brokebit/PA-Sequencer-Hardware/Sequencer-3d.png

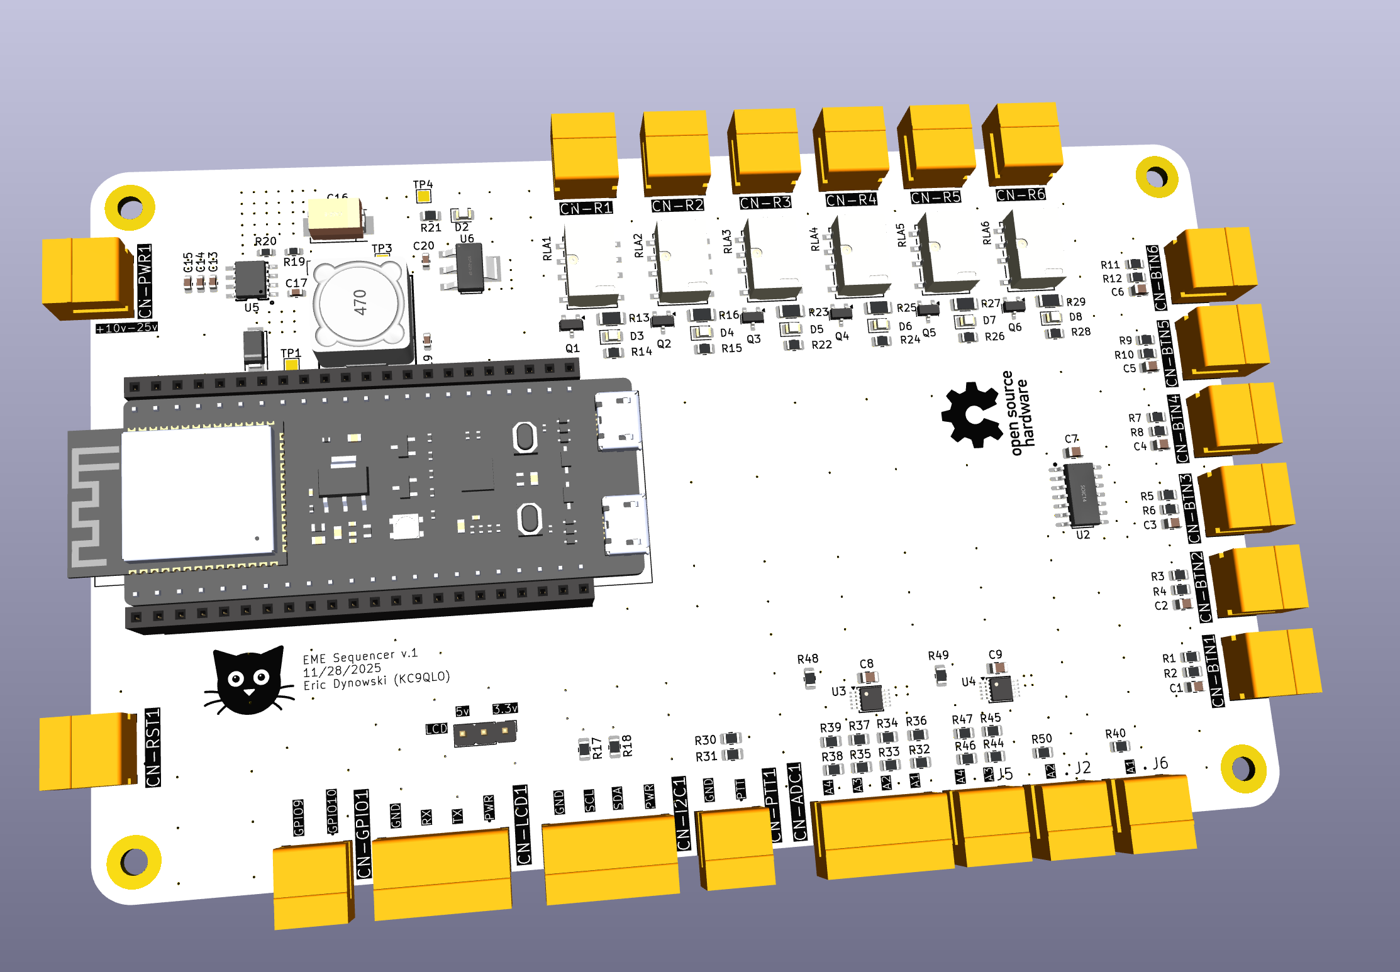
Sequencer-3d.png
