brokebit/PA-Sequencer-Hardware/parts/C2982926_Relay-G6K_2F_Y/G6K_2F_Y.igs

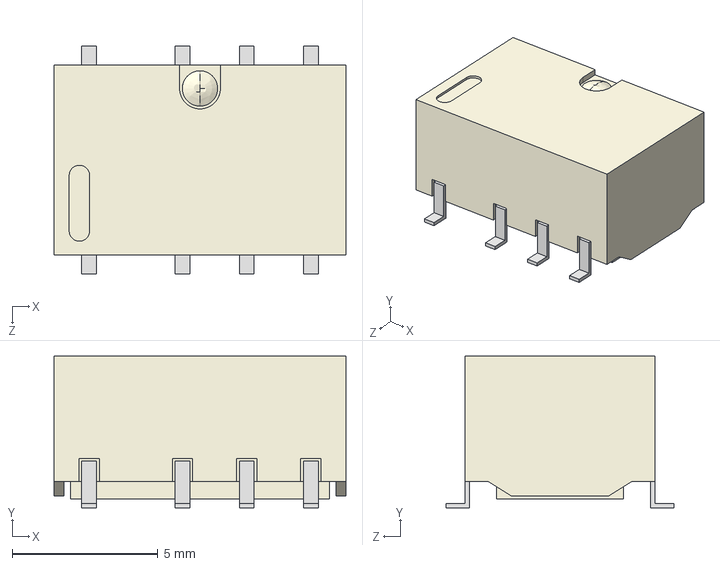
[picture p2: CAD file, 2026-03-26]
parts/C2982926_Relay-G6K_2F_Y/G6K_2F_Y.igs
10.0 x 5.20 x 7.80 mm
