brokebit/PA-Sequencer-Hardware/parts/TBP02R1-381-02OR/TBP02R1-381-02OR.step

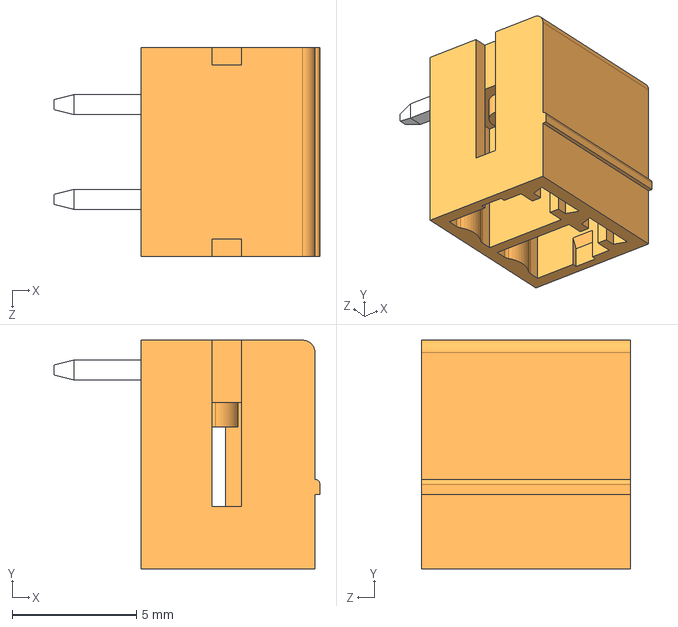
[picture p3: CAD file, 2026-03-26]
parts/TBP02R1-381-02OR/TBP02R1-381-02OR.step
10.7 x 9.20 x 8.41 mm
