brokebit/PA-Sequencer-Hardware/parts/TBP02R1-381-04OR/TBP02R1-381-04OR.step

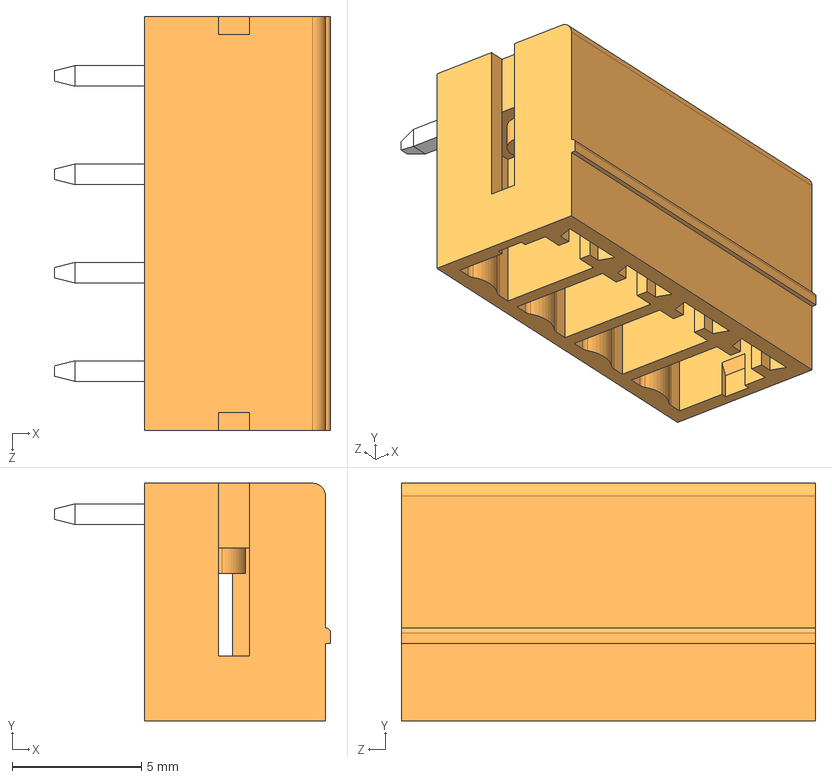
[picture p4: CAD file, 2026-03-26]
parts/TBP02R1-381-04OR/TBP02R1-381-04OR.step
10.7 x 9.20 x 16.0 mm
