brokebit/PA-Sequencer-Hardware/ESP32-Sequencer-v0.2.kicad_pcb

## KiCad design ESP32-Sequencer-v0.2.kicad_pcb (2026-03-26)

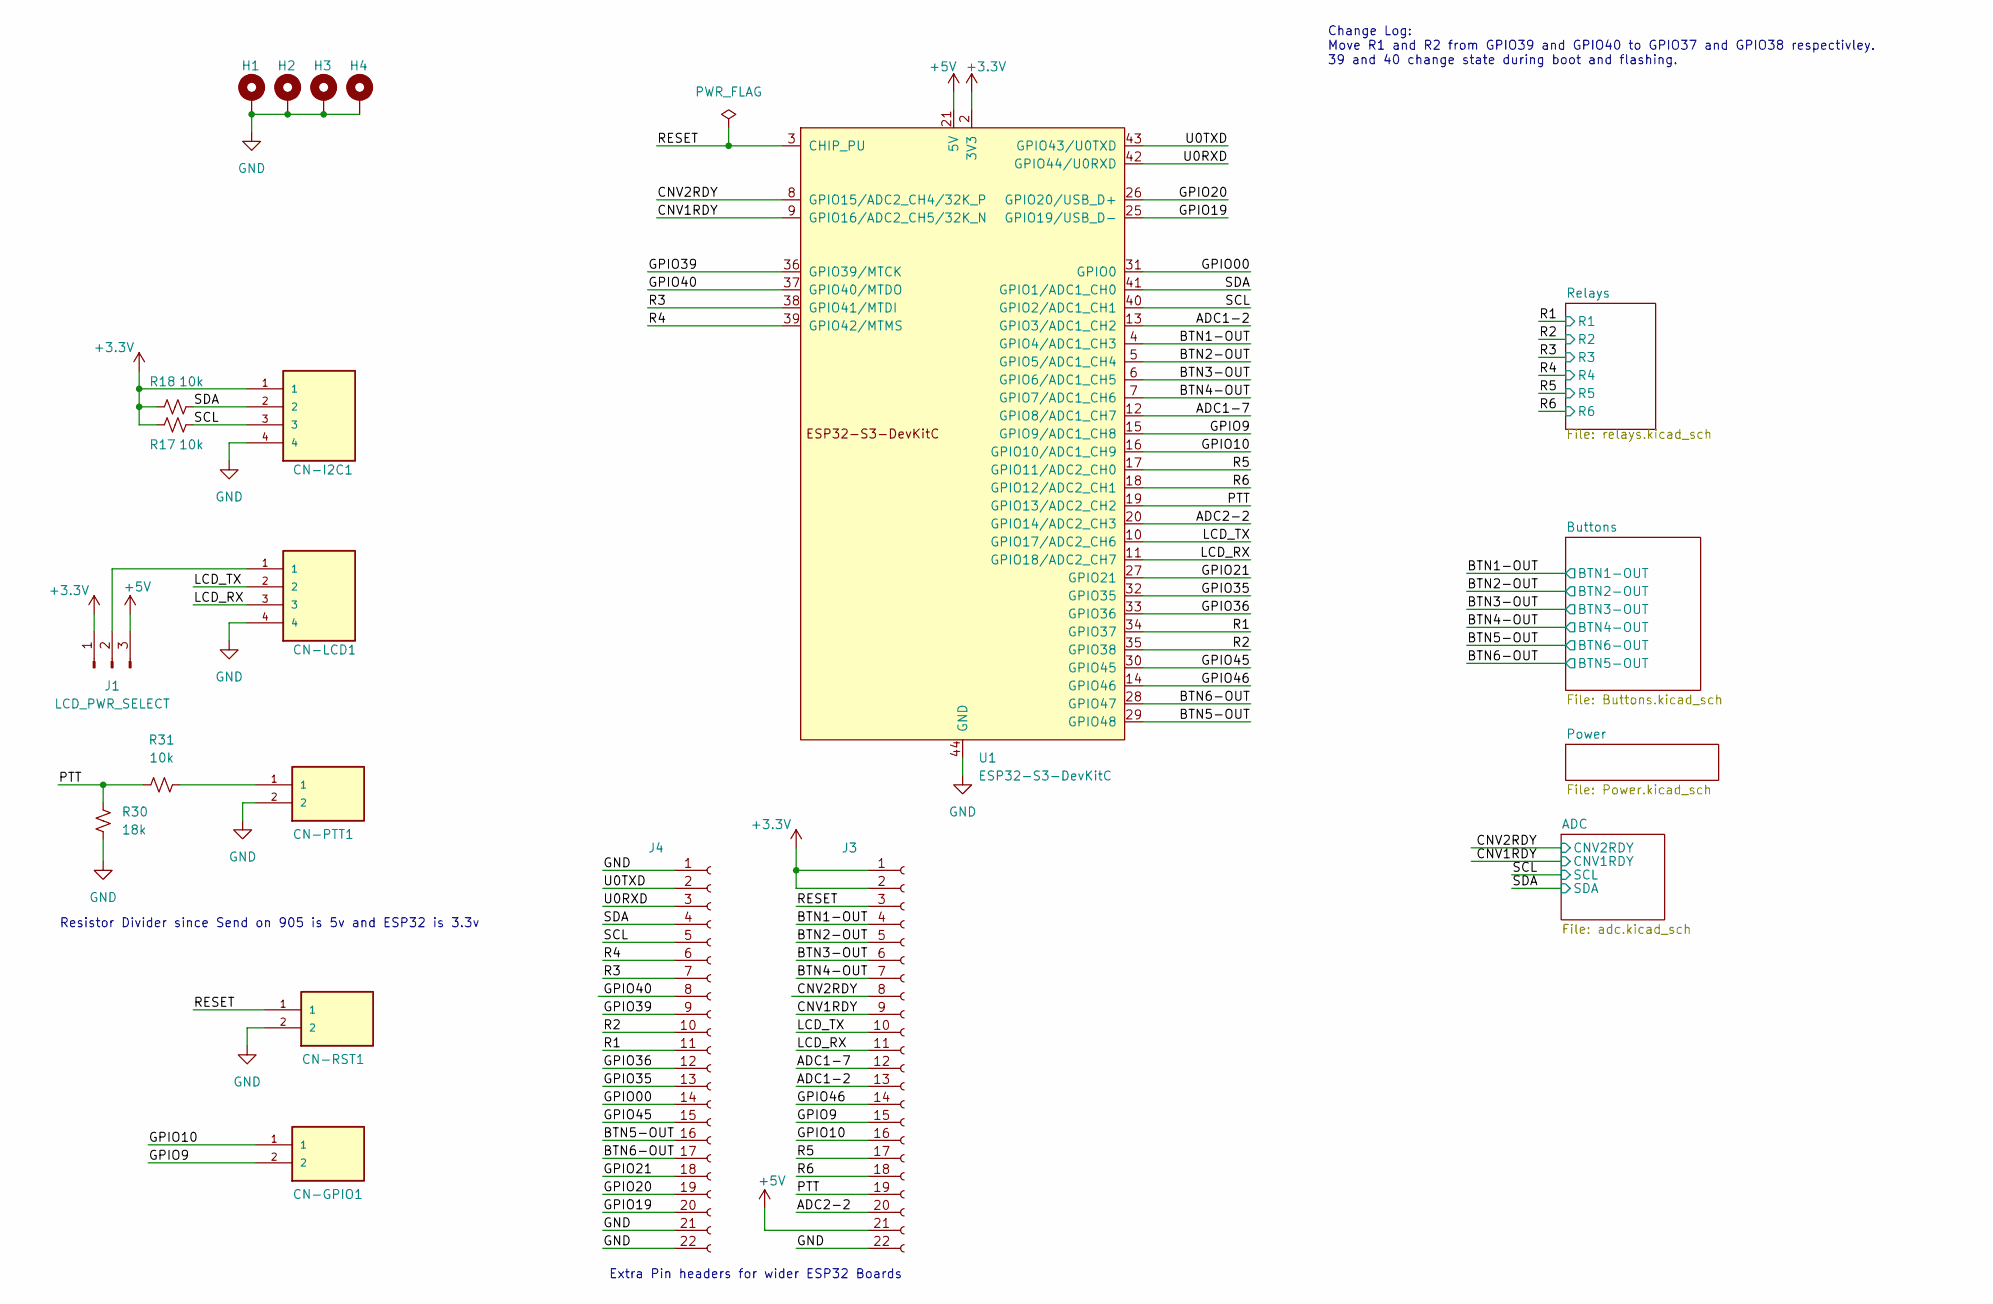
[picture p5: schematic ESP32-Sequencer-v0.2.kicad_sch]

Parts:
CN-GPIO1: TBP02R1-381-02OR; CUI_TBP02R1-381-02OR
CN-I2C1: TBP02R1-381-04OR; CUI_TBP02R1-381-04OR
CN-LCD1: TBP02R1-381-04OR; CUI_TBP02R1-381-04OR
CN-PTT1: TBP02R1-381-02OR; CUI_TBP02R1-381-02OR
CN-RST1: TBP02R1-381-02OR; CUI_TBP02R1-381-02OR
H1, H2, H3, H4: MountingHole_Pad; MountingHole_3.2mm_M3_Pad
J1: LCD_PWR_SELECT; PinHeader_1x03_P2.54mm_Vertical
J3, J4: Conn_01x22_Socket; PinSocket_1x22_P2.54mm_Vertical
R17, R18, R31: 10k; R_0805_2012Metric
R30: 18k; R_0805_2012Metric
U1: ESP32-S3-DevKitC

Connections:
+3.3V: CN-I2C1.1, J1.1, J3.1, J3.2, R17.1, R18.1, U1.1 (3V3), U1.2 (3V3); also elsewhere on the board
+5V: J1.3, J3.21, U1.21 (5V); also elsewhere on the board
/ADC1-2: J3.13, U1.13 (GPIO3/ADC1_CH2)
/ADC1-7: J3.12, U1.12 (GPIO8/ADC1_CH7)
/ADC2-2: J3.20, U1.20 (GPIO14/ADC2_CH3)
/BTN1-OUT: J3.4, U1.4 (GPIO4/ADC1_CH3); also elsewhere on the board
/BTN2-OUT: J3.5, U1.5 (GPIO5/ADC1_CH4); also elsewhere on the board
/BTN3-OUT: J3.6, U1.6 (GPIO6/ADC1_CH5); also elsewhere on the board
/BTN4-OUT: J3.7, U1.7 (GPIO7/ADC1_CH6); also elsewhere on the board
/BTN5-OUT: J4.16, U1.29 (GPIO48); also elsewhere on the board
/BTN6-OUT: J4.17, U1.28 (GPIO47); also elsewhere on the board
/CNV1RDY: J3.9, U1.9 (GPIO16/ADC2_CH5/32K_N); also elsewhere on the board
/CNV2RDY: J3.8, U1.8 (GPIO15/ADC2_CH4/32K_P); also elsewhere on the board
/GPIO00: J4.14, U1.31 (GPIO0)
/GPIO9: CN-GPIO1.2, J3.15, U1.15 (GPIO9/ADC1_CH8)
/GPIO10: CN-GPIO1.1, J3.16, U1.16 (GPIO10/ADC1_CH9)
/GPIO19: J4.20, U1.25 (GPIO19/USB_D-)
/GPIO20: J4.19, U1.26 (GPIO20/USB_D+)
/GPIO21: J4.18, U1.27 (GPIO21)
/GPIO35: J4.13, U1.32 (GPIO35)
/GPIO36: J4.12, U1.33 (GPIO36)
/GPIO39: J4.9, U1.36 (GPIO39/MTCK)
/GPIO40: J4.8, U1.37 (GPIO40/MTDO)
/GPIO45: J4.15, U1.30 (GPIO45)
/GPIO46: J3.14, U1.14 (GPIO46)
/LCD_RX: CN-LCD1.3, J3.11, U1.11 (GPIO18/ADC2_CH7)
/LCD_TX: CN-LCD1.2, J3.10, U1.10 (GPIO17/ADC2_CH6)
/PTT: J3.19, R30.1, R31.1, U1.19 (GPIO13/ADC2_CH2)
/R1: J4.11, U1.34 (GPIO37); also elsewhere on the board
/R2: J4.10, U1.35 (GPIO38); also elsewhere on the board
/R3: J4.7, U1.38 (GPIO41/MTDI); also elsewhere on the board
/R4: J4.6, U1.39 (GPIO42/MTMS); also elsewhere on the board
/R5: J3.17, U1.17 (GPIO11/ADC2_CH0); also elsewhere on the board
/R6: J3.18, U1.18 (GPIO12/ADC2_CH1); also elsewhere on the board
/RESET: CN-RST1.1, J3.3, U1.3 (CHIP_PU)
/SCL: CN-I2C1.3, J4.5, R17.2, U1.40 (GPIO2/ADC1_CH1); also elsewhere on the board
/SDA: CN-I2C1.2, J4.4, R18.2, U1.41 (GPIO1/ADC1_CH0); also elsewhere on the board
/U0RXD: J4.3, U1.42 (GPIO44/U0RXD)
/U0TXD: J4.2, U1.43 (GPIO43/U0TXD)
GND: CN-I2C1.4, CN-LCD1.4, CN-PTT1.2, CN-RST1.2, H1.1, H2.1, H3.1, H4.1, J3.22, J4.1, J4.21, J4.22, R30.2, U1.22 (GND), U1.23 (GND), U1.24 (GND), U1.44 (GND); also elsewhere on the board
unnamed: CN-PTT1.1, R31.2
unnamed: CN-LCD1.1, J1.2

Notes on the sheet:
Change Log: Move R1 and R2 from GPIO39 and GPIO40 to GPIO37 and GPIO38 respectivley. 39 and 40 change state during boot and flashing.
Resistor Divider since Send on 905 is 5v and ESP32 is 3.3v
Extra Pin headers for wider ESP32 Boards

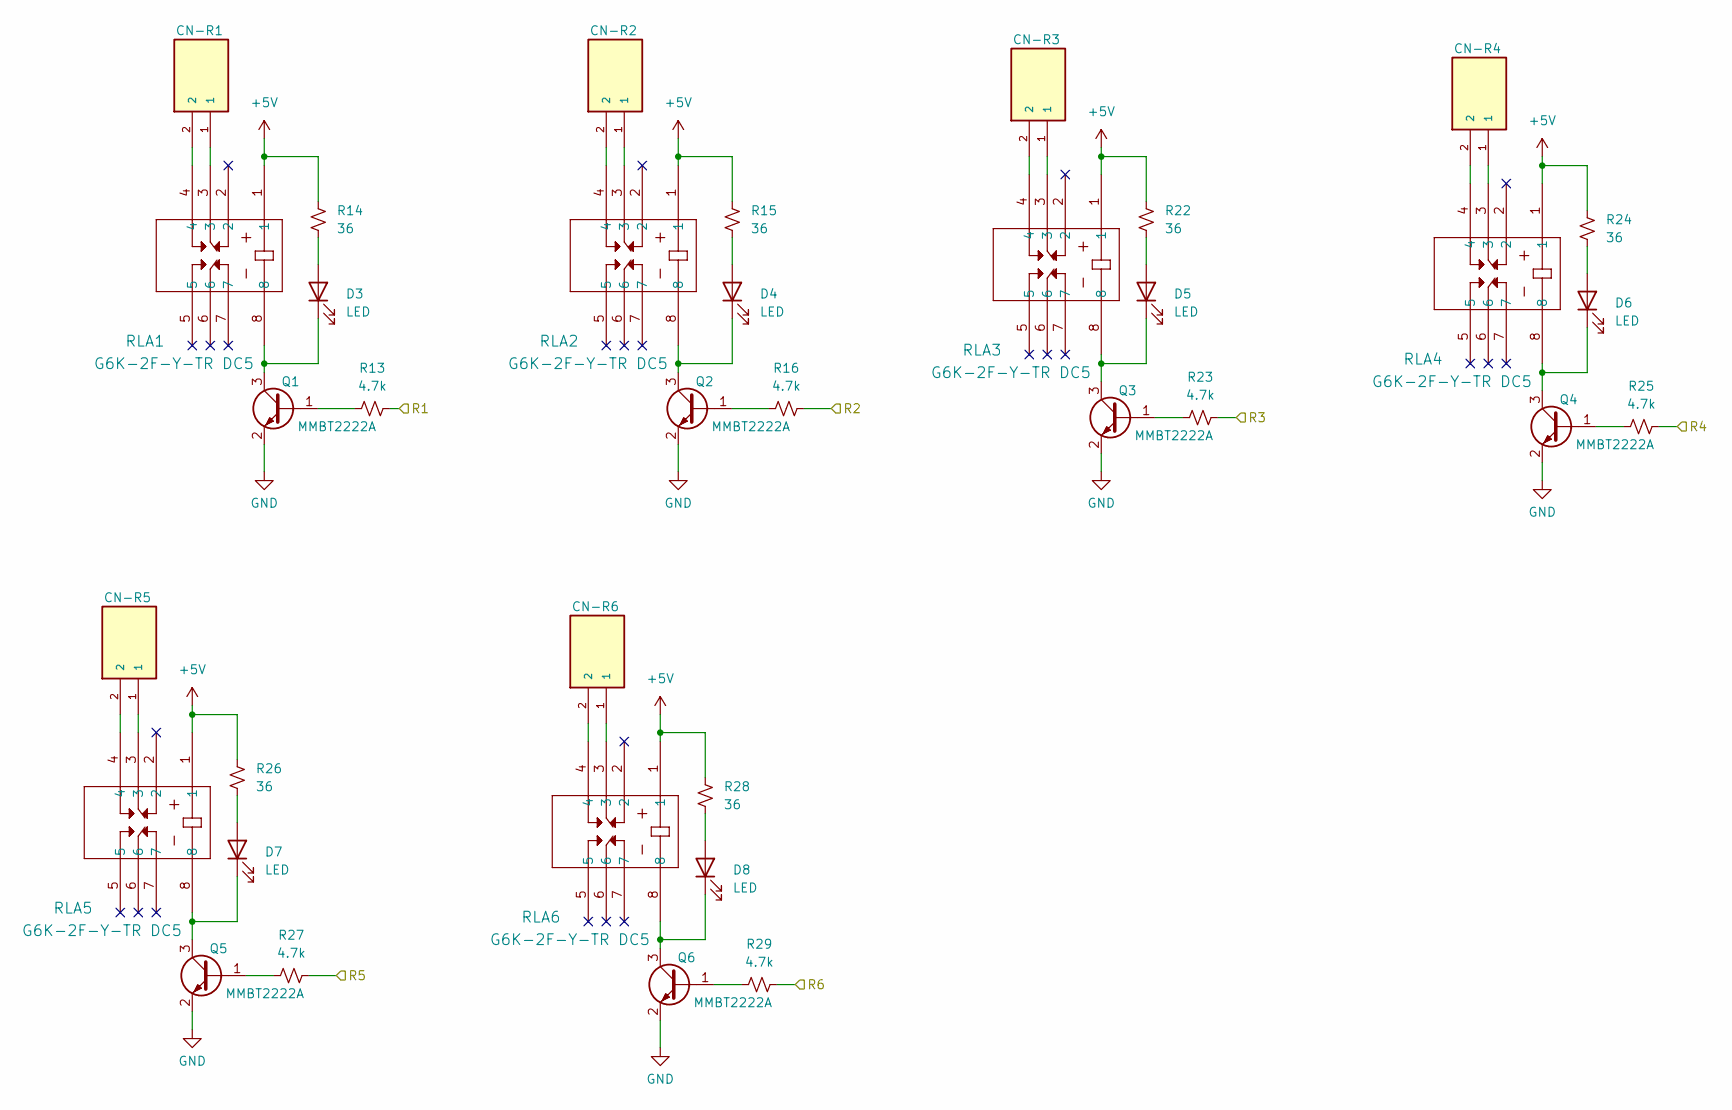
[picture p6: schematic relays.kicad_sch]

Parts:
CN-R1, CN-R2, CN-R3, CN-R4, CN-R5, CN-R6: TBP02R1-381-02OR; CUI_TBP02R1-381-02OR
D3, D4, D5, D6, D7, D8: LED; LED_0805_2012Metric; LCSC C84260
Q1, Q2, Q3, Q4, Q5, Q6: MMBT2222A; SOT-23
R13, R16, R23, R25, R27, R29: 4.7k; R_1206_3216Metric
R14, R15, R22, R24, R26, R28: 36; R_0805_2012Metric
RLA1, RLA2, RLA3, RLA4, RLA5, RLA6: G6K-2F-Y-TR DC5; G6K-2F-Y DC3

Connections:
+5V: R14.1, R15.1, R22.1, R24.1, R26.1, R28.1, RLA1.1, RLA2.1, RLA3.1, RLA4.1, RLA5.1, RLA6.1; also elsewhere on the board
/R1: R13.2; also elsewhere on the board
/R2: R16.2; also elsewhere on the board
/R3: R23.2; also elsewhere on the board
/R4: R25.2; also elsewhere on the board
/R5: R27.2; also elsewhere on the board
/R6: R29.2; also elsewhere on the board
GND: Q1.2 (E), Q2.2 (E), Q3.2 (E), Q4.2 (E), Q5.2 (E), Q6.2 (E); also elsewhere on the board
unnamed: CN-R1.1, RLA1.3
unnamed: CN-R1.2, RLA1.4
unnamed: CN-R2.1, RLA2.3
unnamed: CN-R2.2, RLA2.4
unnamed: CN-R3.1, RLA3.3
unnamed: CN-R3.2, RLA3.4
unnamed: CN-R4.1, RLA4.3
unnamed: CN-R4.2, RLA4.4
unnamed: CN-R5.1, RLA5.3
unnamed: CN-R5.2, RLA5.4
unnamed: CN-R6.1, RLA6.3
unnamed: CN-R6.2, RLA6.4
unnamed: D3.2 (A), R14.2
unnamed: D3.1 (K), Q1.3 (C), RLA1.8
unnamed: D4.2 (A), R15.2
unnamed: D4.1 (K), Q2.3 (C), RLA2.8
unnamed: D5.2 (A), R22.2
unnamed: D5.1 (K), Q3.3 (C), RLA3.8
unnamed: D6.2 (A), R24.2
unnamed: D6.1 (K), Q4.3 (C), RLA4.8
unnamed: D7.2 (A), R26.2
unnamed: D7.1 (K), Q5.3 (C), RLA5.8
unnamed: D8.2 (A), R28.2
unnamed: D8.1 (K), Q6.3 (C), RLA6.8
unnamed: Q1.1 (B), R13.1
unnamed: Q2.1 (B), R16.1
unnamed: Q3.1 (B), R23.1
unnamed: Q4.1 (B), R25.1
unnamed: Q5.1 (B), R27.1
unnamed: Q6.1 (B), R29.1

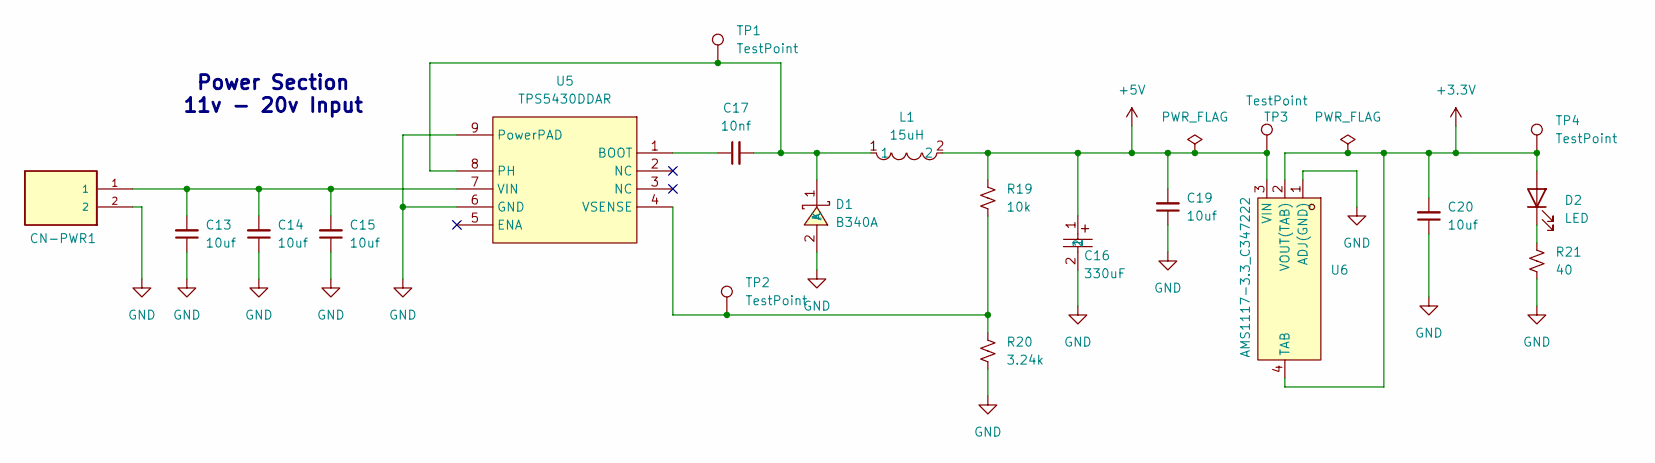
[picture p7: schematic Power.kicad_sch]

Parts:
C13, C14, C15, C19, C20: 10uf; C_0603_1608Metric
C16: 330uF; CAP-SMD_L7.3-W4.3-R-RD; LCSC Part C79112
C17: 10nf; C_0603_1608Metric
CN-PWR1: TBP02R1-381-02OR; CUI_TBP02R1-381-02OR
D1: B340A; SMA_L4.3-W2.6-LS5.1-RD; LCSC Part C64982
D2: LED; LED_0805_2012Metric; LCSC Part C84260
L1: 15uH; IND-SMD_L12.5-W12.5_RLF12545T; LCSC Part C40000
R19: 10k; R_0603_1608Metric
R20: 3.24k; R_0603_1608Metric
R21: 40; R_0805_2012Metric; LCSC Part C2930194
TP1, TP2, TP3, TP4: TestPoint; TestPoint_Pad_1.5x1.5mm
U5: TPS5430DDAR; ESOP-8_L4.9-W3.9-P1.27-LS6.0-TL-EP; LCSC Part C9864
U6: AMS1117-3.3_C347222; SOT-223-4_L6.5-W3.5-P2.30-LS7.0-BR; LCSC Part C347222

Connections:
+3.3V: C20.2, D2.2 (A), TP4.1, U6.2 (VOUT(TAB)), U6.4 (TAB); also elsewhere on the board
+5V: C16.1, C19.2, L1.2, R19.1, TP3.1, U6.3 (VIN); also elsewhere on the board
GND: C13.1, C14.1, C15.1, C16.2, C19.1, C20.1, CN-PWR1.2, D1.2 (A), R20.2, R21.2, U5.6 (GND), U5.9 (PowerPAD), U6.1 (ADJ(GND)); also elsewhere on the board
unnamed: C17.2, D1.1 (K), L1.1, TP1.1, U5.8 (PH)
unnamed: D2.1 (K), R21.1
unnamed: C17.1, U5.1 (BOOT)
unnamed: C13.2, C14.2, C15.2, CN-PWR1.1, U5.7 (VIN)
unnamed: R19.2, R20.1, TP2.1, U5.4 (VSENSE)

Notes on the sheet:
Power Section 11v - 20v Input

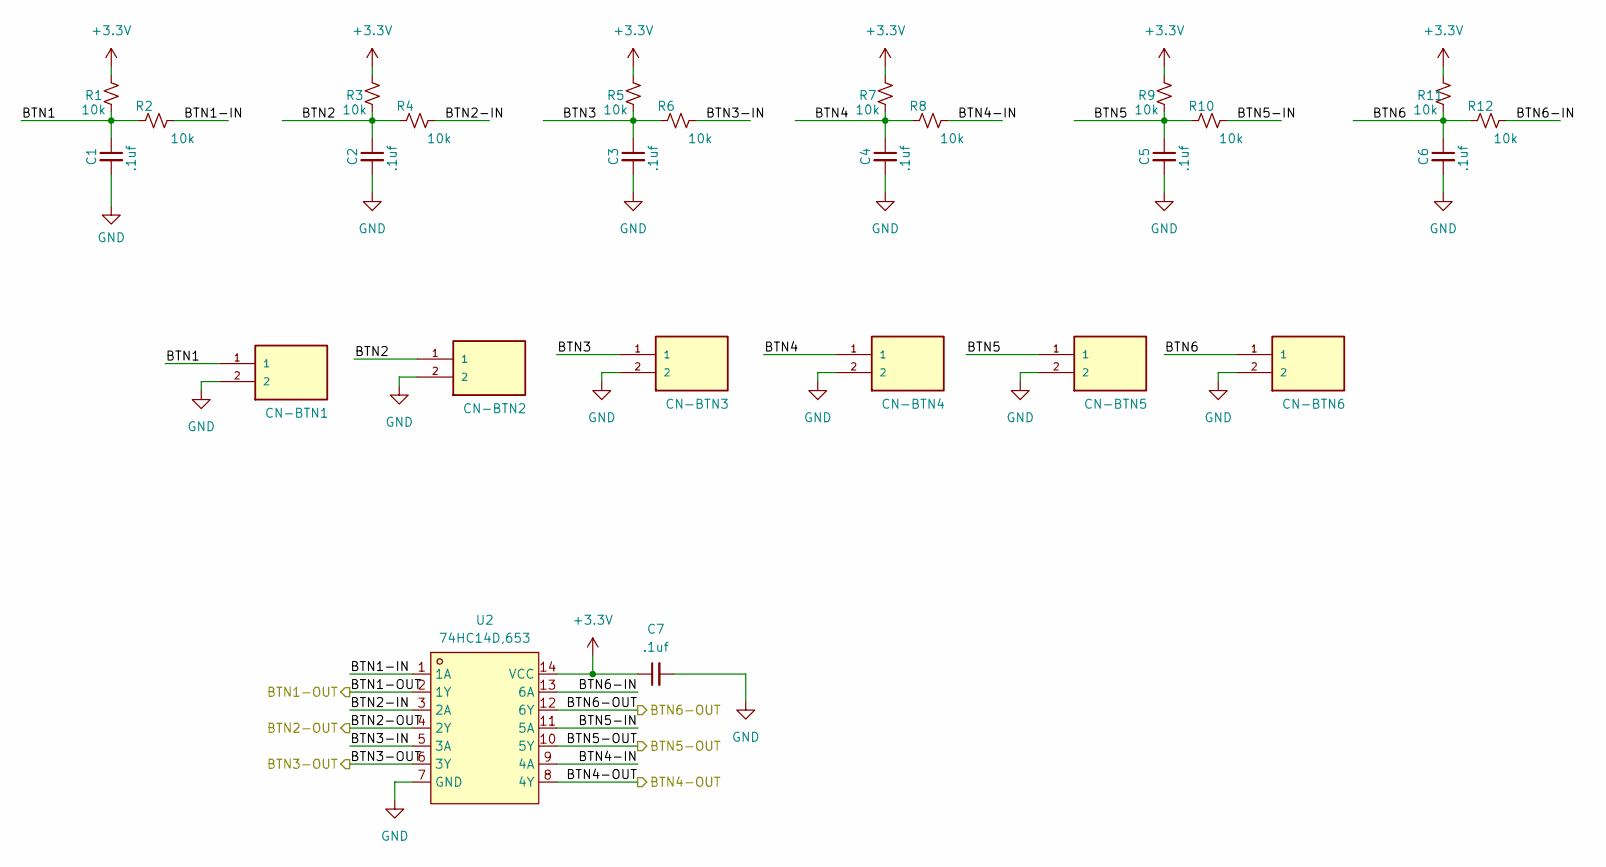
[picture p8: schematic Buttons.kicad_sch]

Parts:
C1, C2, C3, C4, C5, C6, C7: .1uf; C_0805_2012Metric
CN-BTN1, CN-BTN2, CN-BTN3, CN-BTN4, CN-BTN5, CN-BTN6: TBP02R1-381-02OR; CUI_TBP02R1-381-02OR
R1, R2, R3, R4, R5, R6, R7, R8, R9, R10, R11, R12: 10k; R_0805_2012Metric
U2: 74HC14D,653; SOIC-14_L8.7-W3.9-P1.27-LS6.0-BL; LCSC Part C5605

Connections:
+3.3V: C7.1, R1.1, R3.1, R5.1, R7.1, R9.1, R11.1, U2.14 (VCC); also elsewhere on the board
/BTN1-OUT: U2.2 (1Y); also elsewhere on the board
/BTN2-OUT: U2.4 (2Y); also elsewhere on the board
/BTN3-OUT: U2.6 (3Y); also elsewhere on the board
/BTN4-OUT: U2.8 (4Y); also elsewhere on the board
/BTN5-OUT: U2.12 (6Y); also elsewhere on the board
/BTN6-OUT: U2.10 (5Y); also elsewhere on the board
/Buttons/BTN1: C1.1, CN-BTN1.1, R1.2, R2.2
/Buttons/BTN1-IN: R2.1, U2.1 (1A)
/Buttons/BTN2: C2.1, CN-BTN2.1, R3.2, R4.2
/Buttons/BTN2-IN: R4.1, U2.3 (2A)
/Buttons/BTN3: C3.1, CN-BTN3.1, R5.2, R6.2
/Buttons/BTN3-IN: R6.1, U2.5 (3A)
/Buttons/BTN4: C4.1, CN-BTN4.1, R7.2, R8.2
/Buttons/BTN4-IN: R8.1, U2.9 (4A)
/Buttons/BTN5: C5.1, CN-BTN5.1, R9.2, R10.2
/Buttons/BTN5-IN: R10.1, U2.11 (5A)
/Buttons/BTN6: C6.1, CN-BTN6.1, R11.2, R12.2
/Buttons/BTN6-IN: R12.1, U2.13 (6A)
GND: C1.2, C2.2, C3.2, C4.2, C5.2, C6.2, C7.2, CN-BTN1.2, CN-BTN2.2, CN-BTN3.2, CN-BTN4.2, CN-BTN5.2, CN-BTN6.2, U2.7 (GND); also elsewhere on the board

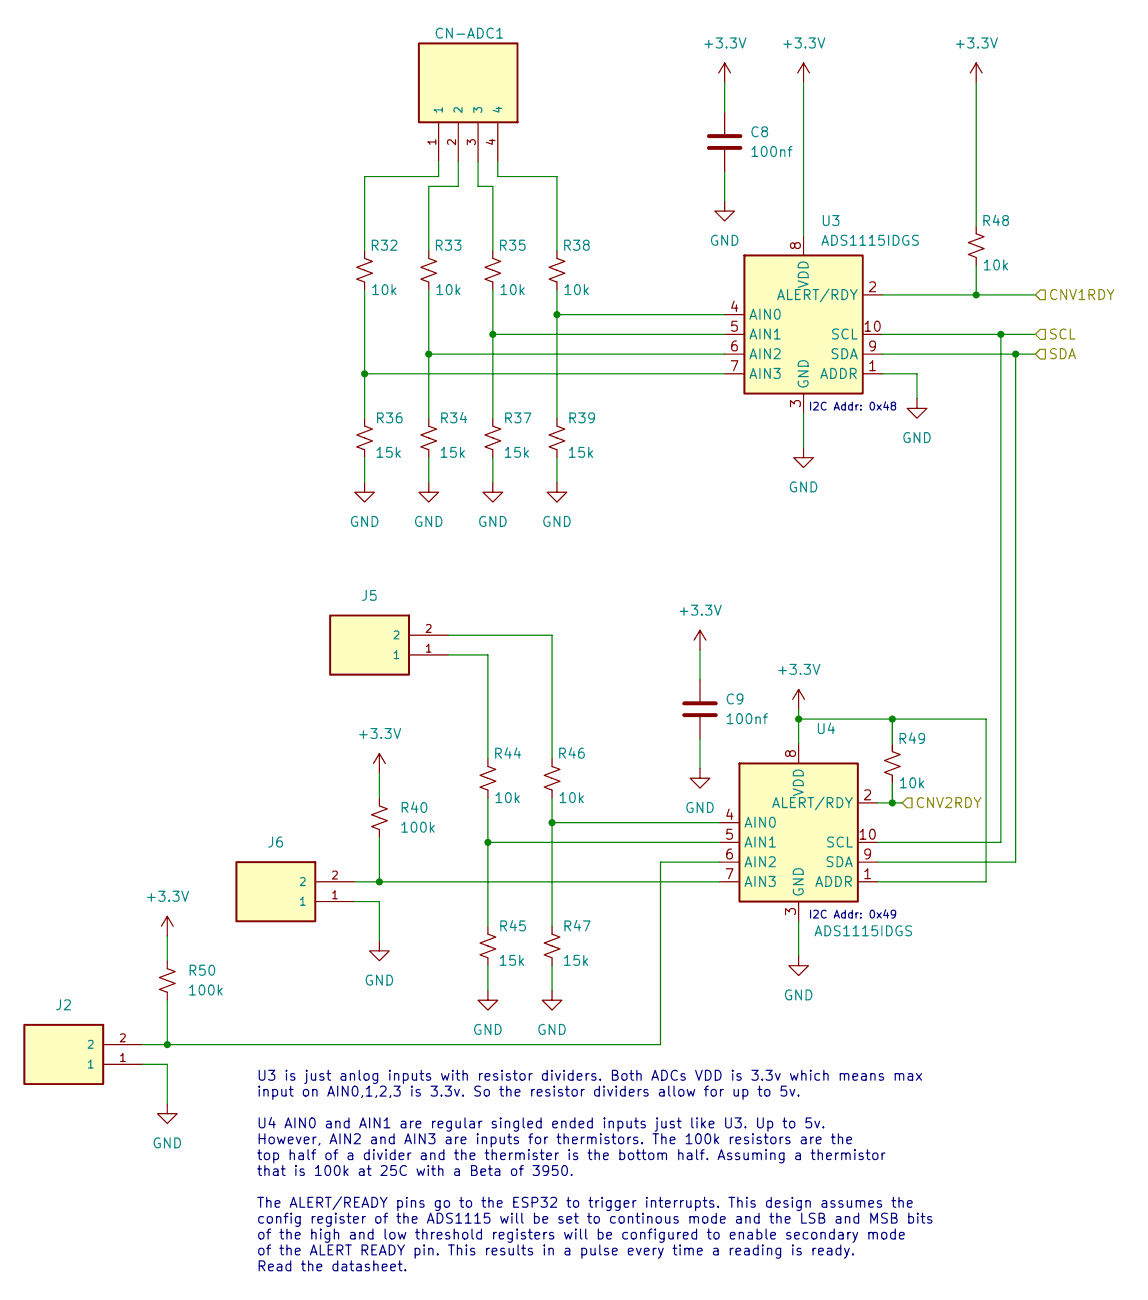
[picture p9: schematic adc.kicad_sch]

Parts:
C8, C9: 100nf; C_0805_2012Metric
CN-ADC1: TBP02R1-381-04OR; CUI_TBP02R1-381-04OR
J2, J5, J6: TBP02R1-381-02OR; CUI_TBP02R1-381-02OR
R32, R33, R35, R38, R44, R46, R48, R49: 10k; R_0805_2012Metric
R34, R36, R37, R39, R45, R47: 15k; R_0805_2012Metric
R40, R50: 100k; R_0805_2012Metric
U3, U4: ADS1115IDGS; TSSOP-10_3x3mm_P0.5mm

Connections:
+3.3V: C8.1, C9.1, R40.1, R48.1, R49.1, R50.1, U3.8 (VDD), U4.1 (ADDR), U4.8 (VDD); also elsewhere on the board
/CNV1RDY: R48.2, U3.2 (ALERT/RDY); also elsewhere on the board
/CNV2RDY: R49.2, U4.2 (ALERT/RDY); also elsewhere on the board
/SCL: U3.10 (SCL), U4.10 (SCL); also elsewhere on the board
/SDA: U3.9 (SDA), U4.9 (SDA); also elsewhere on the board
GND: C8.2, C9.2, J2.1, J6.1, R34.2, R36.2, R37.2, R39.2, R45.2, R47.2, U3.1 (ADDR), U3.3 (GND), U4.3 (GND); also elsewhere on the board
unnamed: CN-ADC1.1, R32.1
unnamed: CN-ADC1.2, R33.1
unnamed: CN-ADC1.3, R35.1
unnamed: CN-ADC1.4, R38.1
unnamed: J5.1, R44.1
unnamed: J5.2, R46.1
unnamed: R38.2, R39.1, U3.4 (AIN0)
unnamed: R35.2, R37.1, U3.5 (AIN1)
unnamed: R33.2, R34.1, U3.6 (AIN2)
unnamed: R32.2, R36.1, U3.7 (AIN3)
unnamed: R46.2, R47.1, U4.4 (AIN0)
unnamed: R44.2, R45.1, U4.5 (AIN1)
unnamed: J2.2, R50.2, U4.6 (AIN2)
unnamed: J6.2, R40.2, U4.7 (AIN3)

Notes on the sheet:
U3 is just anlog inputs with resistor dividers. Both ADCs VDD is 3.3v which means max input on AIN0,1,2,3 is 3.3v. So the resistor dividers allow for up to 5v. U4 AIN0 and AIN1 are regular singled ended inputs just like U3. Up to 5v. However, AIN2 and AIN3 are inputs for thermistors. The 100k resis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
I2C Addr: 0x48
I2C Addr: 0x49

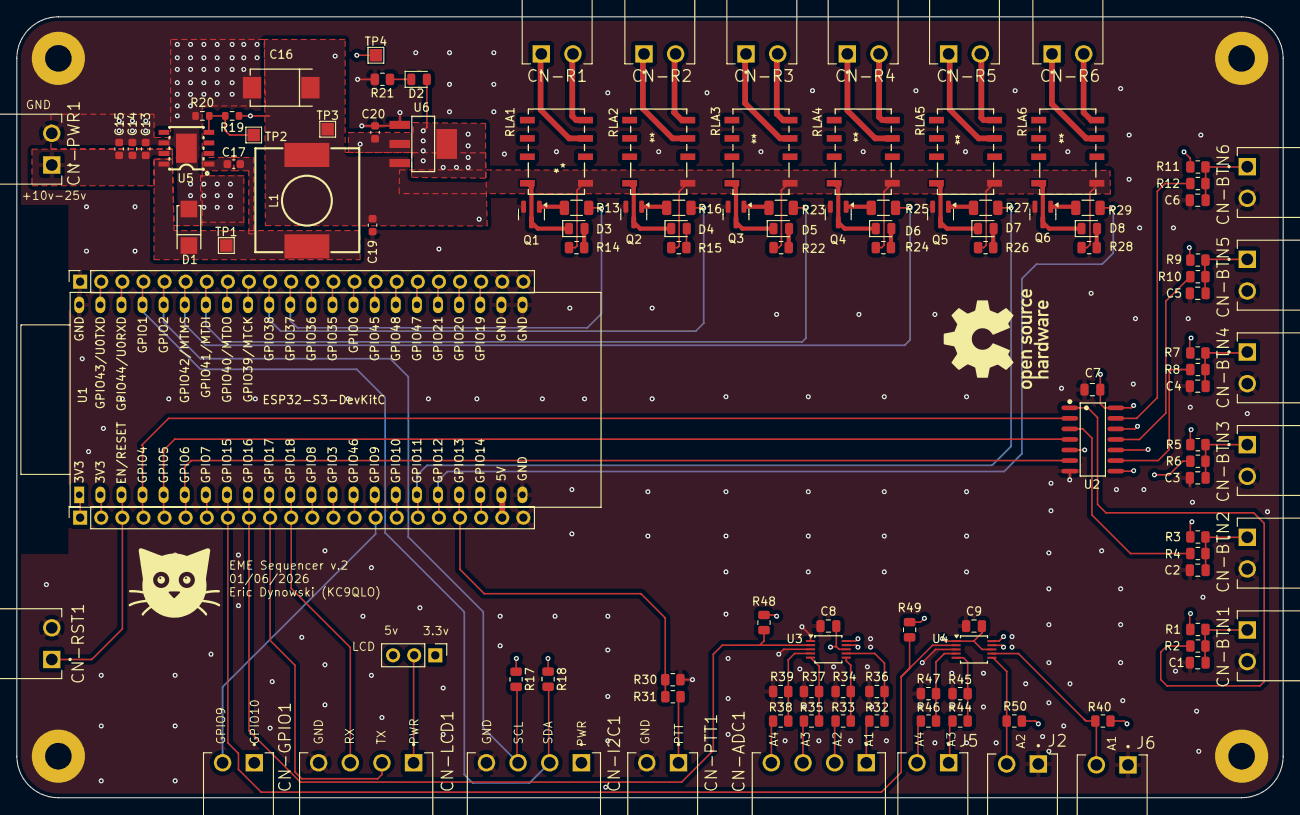
[picture p10: board ESP32-Sequencer-v0.2.kicad_pcb from above]

Board: 6 copper layers, 152.4 x 94.0 mm, 123 parts (0 on the bottom side), 103 nets.
